Parthiban733/soft-pneumatic-gripper/paper/README.md

# Academic Publication Details

This repository accompanies the research paper / book chapter published with **Springer Nature**:

---

## Publication Metadata

- **Chapter Title**: *A Soft, Multi-finger Pneumatic Gripper for Versatile and Safe Object Handling*
- **Book Title**: *Advancements in Automation, Robotics and Sensing*
- **Publisher**: Springer Nature Switzerland / ICST Institute for Computer Sciences, Social Informatics and Telecommunications Engineering
- **Copyright Year**: 2027

---

## Authors & Affiliations

1. **R. Sarvesh** (Corresponding Author)
   - *Department of Robotics and Automation Engineering, PSG College of Technology, Coimbatore, 641004, Tamil Nadu, India*
   - Email: `sarvesh.r.clg@gmail.com`
   - ORCID: [0009-0000-4367-1953](https://orcid.org/0009-0000-4367-1953)
2. **M. Parthiban**
   - *Department of Robotics and Automation Engineering, PSG College of Technology, Coimbatore, 641004, Tamil Nadu, India*
   - Email: `parthiban272005@gmail.com`
   - ORCID: [0009-0003-9127-4938](https://orcid.org/0009-0003-9127-4938)
3. **K. Vijitha**
   - *Department of Robotics and Automation Engineering, PSG College of Technology, Coimbatore, 641004, Tamil Nadu, India*
   - Email: `kvijitha942006@gmail.com`
   - ORCID: [0009-0005-7389-2470](https://orcid.org/0009-0005-7389-2470)
4. **S. Udhayamathi**
   - *Department of Robotics and Automation Engineering, PSG College of Technology, Coimbatore, 641004, Tamil Nadu, India*
   - Email: `udhayamathi0706@gmail.com`
   - ORCID: [0009-0000-6932-1943](https://orcid.org/0009-0000-6932-1943)
5. **Dr. V. Vishwa Priya**
   - *Department of Robotics and Automation Engineering, PSG College of Technology, Coimbatore, 641004, Tamil Nadu, India*
   - Email: `vvp.rae@psgtech.ac.in`
   - ORCID: [0000-0003-2493-7511](https://orcid.org/0000-0003-2493-7511)
6. **Dr. S. Prabhakaran**
   - *Department of Robotics and Automation Engineering, PSG College of Technology, Coimbatore, 641004, Tamil Nadu, India*
   - Email: `spk.rae@psgtech.ac.in`

---

## Abstract

This article introduces a soft 3-claw pneumatic gripper designed for adaptive and dexterous object manipulation. Liquid silicone rubber (LSR-105) is incorporated for handling delicate and non-uniform objects. The system can be utilized across soft robotics in unstructured environments and industrial automation. Influenced by bionics, the design mirrors nature (specifically octopus tentacles and plant tendrils), enabling conforming grasping with evenly distributed contact force. A hybrid two-stage molding technique was developed to create highly repeatable, airtight silicone actuators with embedded chamber geometries. Finite element analysis (FEA) using a 3rd-order Yeoh hyperelastic model validated the deformation characteristics, achieving a bending efficiency of 1.28°/kPa (63.8° at 50 kPa) and an experimental grasping success rate exceeding 95% across 20 distinct object types.

---

## BibTeX Citation

```bibtex
@incollection{sarvesh2027softgripper,
  author    = {Sarvesh, R. and Parthiban, M. and Vijitha, K. and Udhayamathi, S. and Vishwa Priya, V. and Prabhakaran, S.},
  title     = {A Soft, Multi-finger Pneumatic Gripper for Versatile and Safe Object Handling},
  booktitle = {Advancements in Automation, Robotics and Sensing},
  publisher = {Springer Nature Switzerland},
  year      = {2027},
  address   = {Cham, Switzerland}
}
```
