Parthiban733/soft-pneumatic-gripper/ABOUT_ME.md

<div align="center">

# Hi there, I'm Parthiban M 👋
### 🚀 Aspiring Robotics & Automation Engineer | Autonomous Systems & Hardware Innovator






<br/>

> *"Turning mathematical abstractions and mechanical principles into intelligent, physical machines that perceive, adapt, and act in the real world."*

</div>

---

## 🌟 About Me & Engineering Philosophy

I am a passionate **Robotics and Automation Engineering** student at **PSG College of Technology, Coimbatore** (Class of 2027), driven by a relentless curiosity for how hardware, embedded firmware, and intelligent control converge. 

My engineering journey is defined by **hands-on execution** — whether it's casting silicone for soft robotic grippers, tuning PID control loops for aerial systems, implementing real-time digital twins on industrial parallel robots, or navigating GPS-denied autonomous drones with LiDAR and Visual Inertial Odometry. I thrive in multidisciplinary environments where mechanical design, electronics, and autonomous software must integrate seamlessly under real-world constraints.

- 🎓 **Undergraduate**: B.E. Robotics & Automation at **PSG College of Technology** (Expected 2027)
- 🔬 **Research Focus**: Soft Robotics, Planetary Rover Kinematics, Hardware-in-the-Loop Digital Twins, and Autonomous Mobile Robotics
- 🛠️ **Hands-On Mindset**: Rapid prototyping with Fusion 360, 3D printing (FDM), silicone casting, STM32/ESP32 embedded systems, and ROS 2
- 💡 **Current Focus**: Real-time trajectory planning, industrial CAN bus communication, and vision-guided manipulation

---

## 🔬 Research & Publications

- 📖 **Springer Nature (2027)**:  
  *“A Soft, Multi-finger Pneumatic Gripper for Versatile and Safe Object Handling”* — Book: *Advancements in Automation, Robotics and Sensing*.  
  *(Bio-inspired 3-claw gripper, 2-stage LSR-105 silicone casting, Yeoh hyperelastic FEA, >95% grasp success rate).*
- 🪐 **Journal of Soft Computing Paradigm (Dec 2025)**:  
  *“Rocker-Bogie Suspension System for Planetary Exploration: Modeling”* — Vol. 7, No. 4, pp. 311–330.  
  DOI: [10.36548/jscp.2025.4.001](https://doi.org/10.36548/jscp.2025.4.001)

---

## 💼 Industry Experience

- **Robotics Intern** | *Roboto AI Technologies* `(Mar 2026 – May 2026)`  
  - Designed and deployed an **Auto PID Tune** based control system in MATLAB to stabilize a bi-rotor drone using an aeropendulum experimental testbed.
- **Product Engineering Team Intern** | *ABB India Limited, Bengaluru* `(May 2026 – Jul 2026)`  
  - Led process automation and failure forensics for installed Variable Frequency Drives (VFD) base operations, improving diagnostic workflows.
- **Robotics Engineer Trainee** | *Robotica Fa Solutions, Coimbatore* `(Jul 2024)`  
  - Hands-on exposure to industrial robotics assembly, sensor-actuator integration, and rigorous testing methodologies.
- **Executive Member & Public Relations Officer** | *Robotics and Automation Engineering Association (RAEA)* `(Aug 2023 – Jun 2025)`  
  - Coordinated robotics symposiums, technical workshops, and student engineering hackathons.

---

## 🛠️ Technical Arsenal

<div align="center">

| Domain | Technologies & Tools |
| :--- | :--- |
| **Robotics & Autonomy** | **ROS 2 (Jazzy)**, Gazebo, MAVLink, VIO, Visual SLAM, OpenCV, YOLO, Fluid Sim |
| **Microcontrollers & Embedded** | **STM32** (STM32CubeIDE, F103, F411), **ESP32**, Arduino (UNO/Mega), Raspberry Pi 5 |
| **Flight Controllers & Compute** | **Cube Orange+**, Nvidia Jetson Nano, Jetson AGX Orin, USB-to-CAN |
| **Sensors & Perception** | Intel RealSense **D455i & T265 (VIO)**, ZED 2i, **D500 LiDAR**, RPLidar A1/C1, Encoders |
| **CAD & Simulation** | **Autodesk Fusion 360**, AutoCAD, MATLAB / Simulink, FEA Hyperelastic Modeling |
| **Fabrication & Hardware** | 3D Printing (Prusa i3 MK3S, PrusaSlicer), Laser Engraving (LightBurn), Silicone Molding |
| **Industrial Automation** | Siemens PLC, FESTO Robotino, Pneumatics, VFDs, PowerApps, PowerBI |
| **Languages** | Python, C, C++, MATLAB |

</div>

---

## 🚀 Featured Engineering Projects

### 🦾 [Soft Pneumatic Gripper (3-Finger)](https://github.com/Parthiban733/soft-pneumatic-gripper)
*Bio-inspired silicone end-effector for fragile and irregular object handling.*
- Designed parametric molds in Fusion 360 and developed a 2-stage casting protocol with **LSR-105 silicone**.
- Characterized hyperelastic nonlinear behavior using a **3rd-order Yeoh constitutive model** in FEA.
- Achieved **$1.28^\circ/\text{kPa}$** bending efficiency and **$>95\%$ grasp success rate** on 20 fragile object types (eggs, glassware, electronics).

### 🤖 5-Bar Parallel Robot: Hardware-in-the-Loop Digital Twin
*Real-time kinematics and digital twin for industrial planar parallel robots.*
- Developed forward/inverse analytical kinematics and workspace reachability algorithms.
- Built a continuous 3D collision-checking engine and integrated a **USB-to-CAN** interface for live closed-loop encoder feedback.

### 🛸 GPS-Denied Autonomous Drone (ISRO IRoC-U 2025 Challenge)
*Sub-2 kg autonomous multirotor for GPS-denied reconnaissance.*
- Integrated **Cube Orange+** flight controller with **Raspberry Pi 5** companion computer over MAVLink UART.
- Deployed **Intel RealSense T265 (VIO)** and **D500 LiDAR** under **ROS 2 Jazzy** for robust state estimation and local obstacle avoidance.

### 🚜 Caterpillar Autonomy Challenge 2026
*Autonomous 4-wheeled excavation rover.*
- Served as **Team Head**, leading end-to-end mechanical design, electrical integration, and soil excavation bucket mechanism.

### 🪐 ISRO Rover Project (IRoC-U 2024 Challenge)
*Planetary rover mechanical and sensor validation.*
- Served as Technical Assistant; secured **7th Place nationally** across Indian engineering institutions.

---

## 🏆 Honors & Hackathons

- 🥇 **1st Place** — *LOGICX*, ROBOGLITZ '26
- 🥈 **2nd Place** — *PNEUCLUEMATICS*, ROBOGLITZ '26
- 🥇 **1st Place** — *Tracker Monster*, SRISHTI2K23
- 🥉 **3rd Place** — College Sumo Bot Challenge (VEX platform)
- 🏅 **7th Place Nationally** — ISRO Robotics Challenge (IRoC-U 2024)
- 🏅 **Top 12 Finalist** — Janatics National Automation Skill Challenge 2025 (Team Head)
- 🏅 **Top 26 Finalist** — ISRO Robotics Challenge (IRoC-U 2025)

---

## 💬 Connect With Me

I am always excited to discuss robotics innovations, autonomous navigation, compliant mechanisms, and research collaborations!

- 🌐 **Portfolio**: [Google Drive Project Portfolio](https://drive.google.com/drive/folders/1plAiarodJJnpclTDpu9Z_DoSl9fzpq2I)
- 💼 **LinkedIn**: [linkedin.com/in/parthiban-m-55688a286](https://www.linkedin.com/in/parthiban-m-55688a286)
- 📧 **Email**: [parthiban272005@gmail.com](mailto:parthiban272005@gmail.com)
- 📍 **Location**: Coimbatore / Kallakurichi, Tamil Nadu, India

<div align="center">
  <sub>Built with curiosity, precision, and passion for robotics 🤖</sub>
</div>
