Parthiban733/soft-pneumatic-gripper/media/gripper_ready_position.jpg

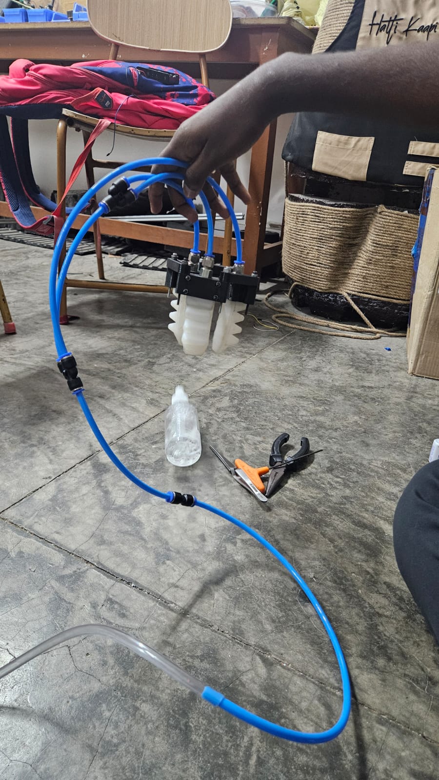
media/gripper_ready_position.jpg
