Parthiban733/soft-pneumatic-gripper/cad/stl/center_mold_chambers.stl

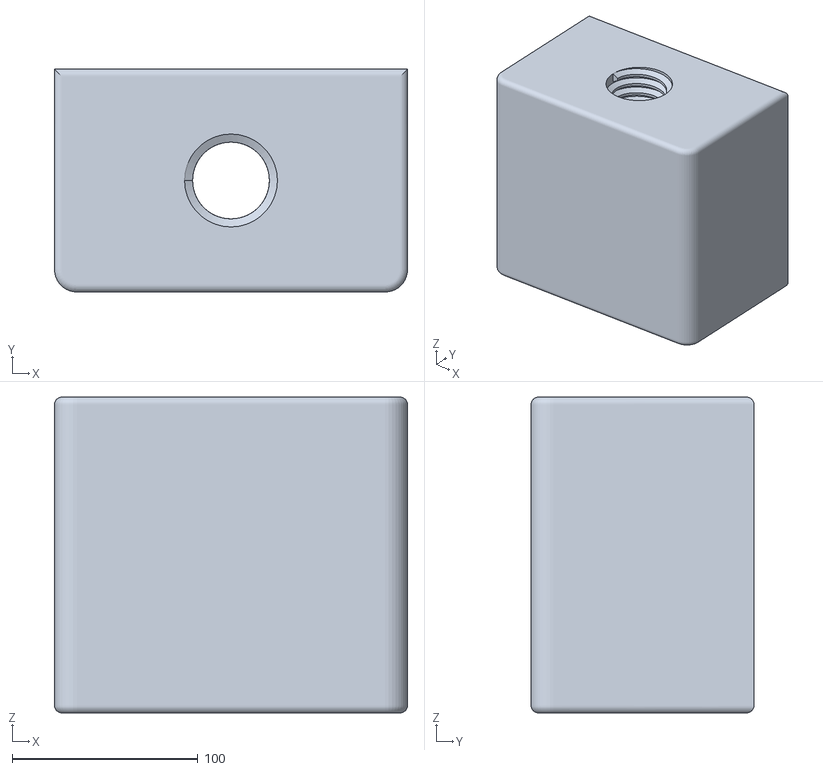
[picture p36: CAD file, 2026-11-01]
cad/stl/center_mold_chambers.stl
190.0 x 120.0 x 170.0
