Parthiban733/soft-pneumatic-gripper/cad/raw/middlefin.stl

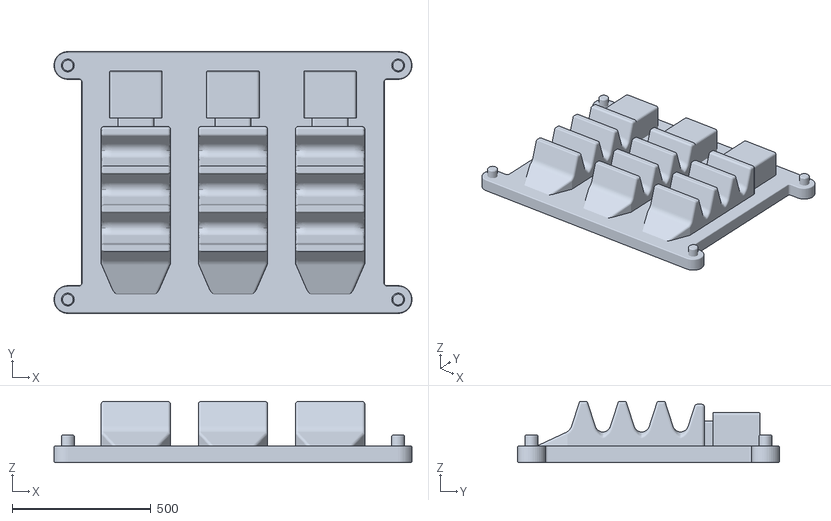
[picture p37: CAD file, 2026-11-01]
cad/raw/middlefin.stl
1289.7 x 943.1 x 220.0
