Parthiban733/soft-pneumatic-gripper/cad/raw/HPPLATE v1.step

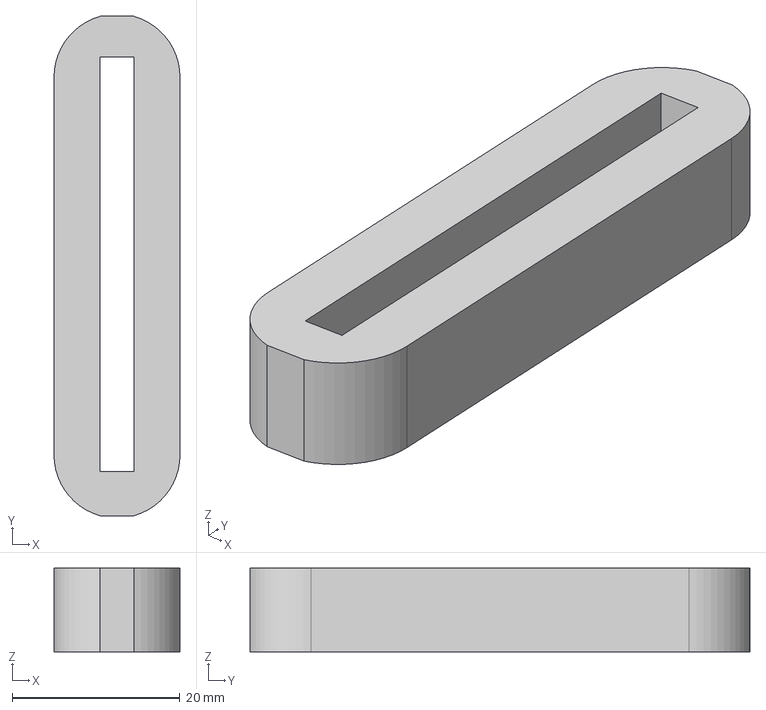
[picture p38: CAD file, 2026-11-01]
cad/raw/HPPLATE v1.step
15.0 x 59.5 x 10.0 mm
