Parthiban733/soft-pneumatic-gripper/cad/stl/base_mold_bottom.stl

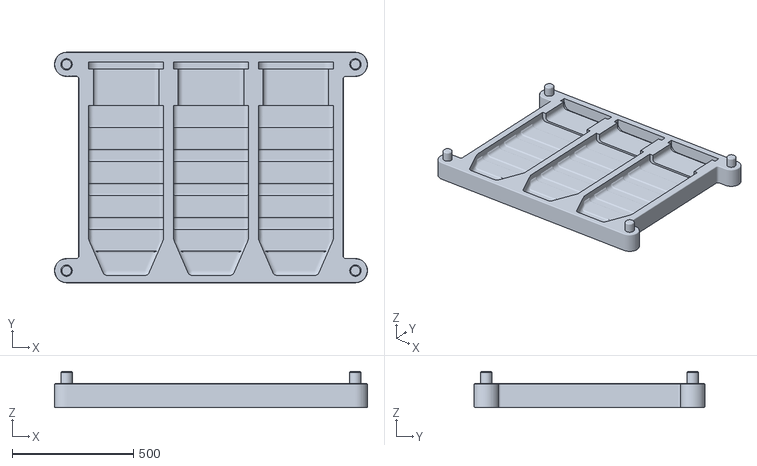
[picture p39: CAD file, 2026-11-01]
cad/stl/base_mold_bottom.stl
1289.7 x 950.0 x 150.0
