Parthiban733/soft-pneumatic-gripper/(list of files, cad)

Other CAD files:
cad/raw/InsertHP.step
cad/step/pneumatic_air_inlet.step
cad/step/middle_mold.step
cad/raw/FINGERHOLDERhp.step
cad/step/finger_holder_bracket.step
cad/step/top_mold_plate.step
cad/raw/BottomHP.step
cad/step/bottom_mold.step
cad/step/finger_insert_core.step
cad/raw/MiddelHP.step
cad/raw/INLEThp.step
cad/raw/TOPplateHp.step
