Parthiban733/soft-pneumatic-gripper/(commit log)

2026-11-01 feat: initial release of bio-inspired soft 3-claw pneumatic gripper research project
    [BottomHP.step, FINGERHOLDERhp.step, HPPLATE v1.step, INLEThp.step, InsertHP.step, MiddelHP.step, TOPplateHp.step, base_mold_bottom.stl]
2026-11-01 docs: update repository clone URL to Parthiban733/soft-pneumatic-gripper
